Vineet-Menon/PDB_v1/Preview_files/PBD_3D.png

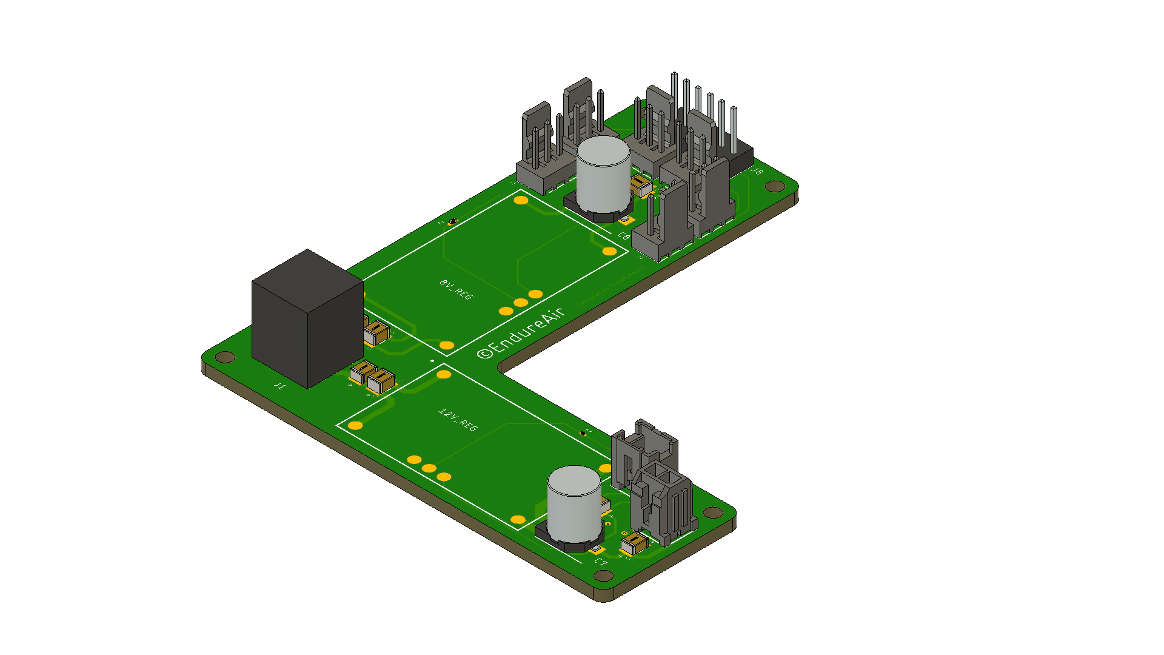
Preview_files/PBD_3D.png
