Vineet-Menon/PDB_v1/Design_files/PDB_final.step

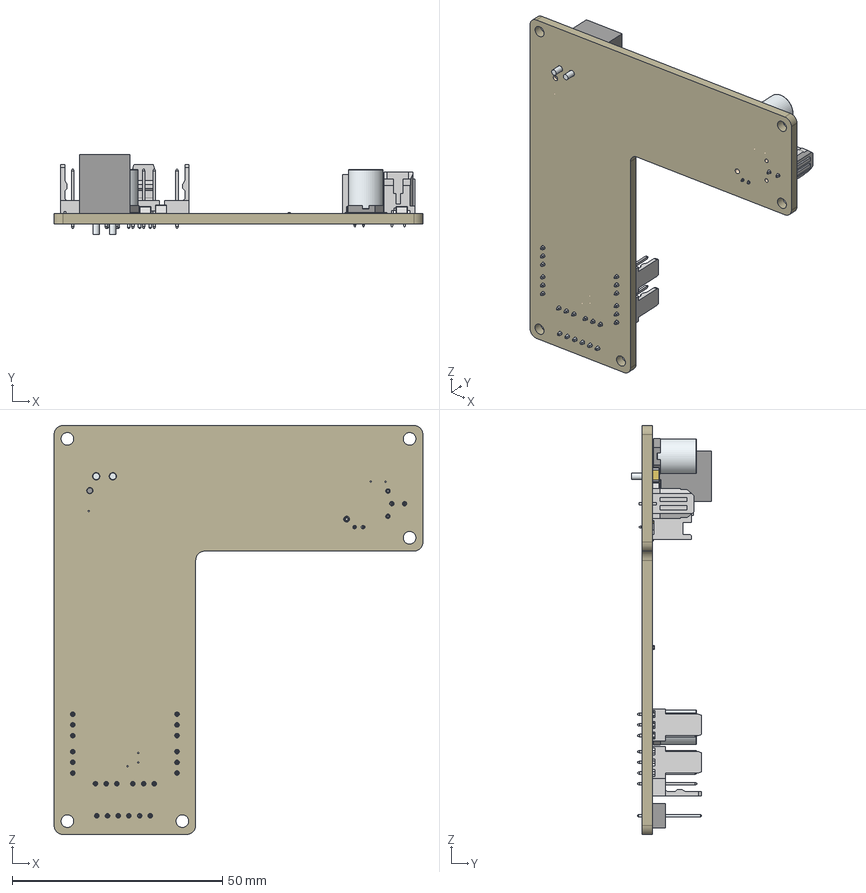
[picture p2: CAD file, 2020-01-20]
Design_files/PDB_final.step
87.6 x 19.1 x 97.2 mm
SimpleBody
LeadsArray
Leads x 3
lug3
Board
Base x 2
Pin1Fillet x 2
Pin2Fillet x 2
Base_75 x 5
Termination_75 x 10
Base_78 x 2
Termination_78 x 4
term1
term2
term1_1
term2_1
