Vineet-Menon/PDB_v1/Library_files/2.54mm_3pin_berg/22-27-2031.stp

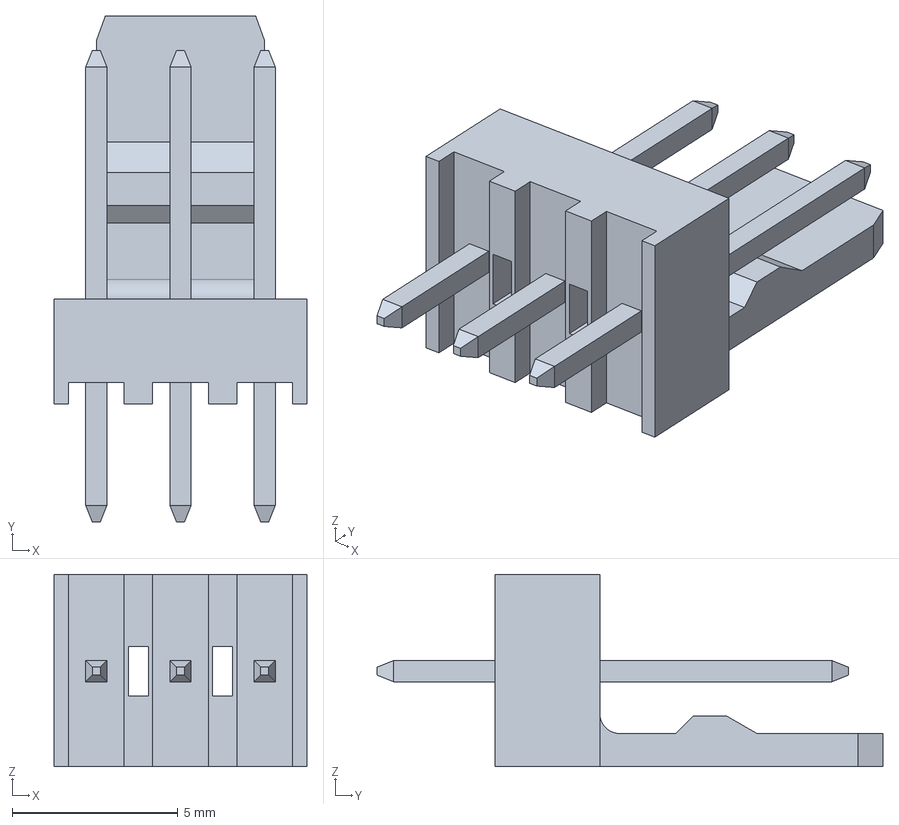
[picture p3: CAD file, 2020-01-20]
Library_files/2.54mm_3pin_berg/22-27-2031.stp
7.62 x 15.3 x 5.80 mm
