Vineet-Menon/PDB_v1/Library_files/2.54mm_6pin_berg/22-27-2061.stp

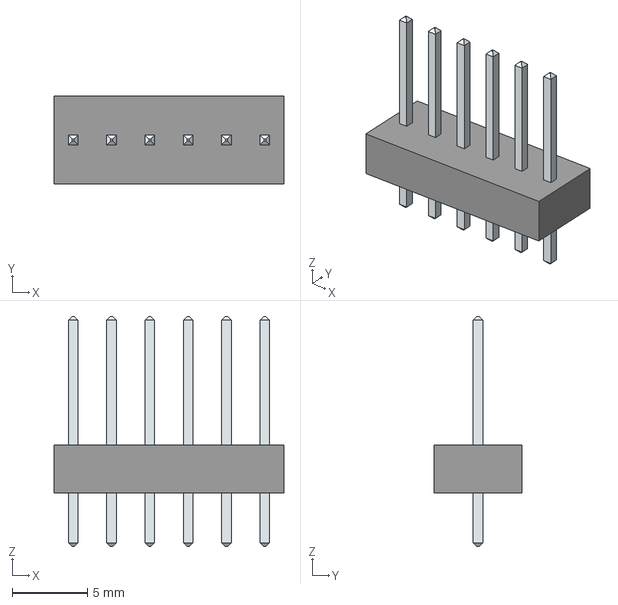
[picture p4: CAD file, 2020-01-20]
Library_files/2.54mm_6pin_berg/22-27-2061.stp
15.2 x 5.80 x 15.3 mm
SimpleBody
LeadsArray
