Vineet-Menon/PDB_v1/Library_files/6.04K_ohm_smd_resistor/ERJ-2RKF6041X.stp

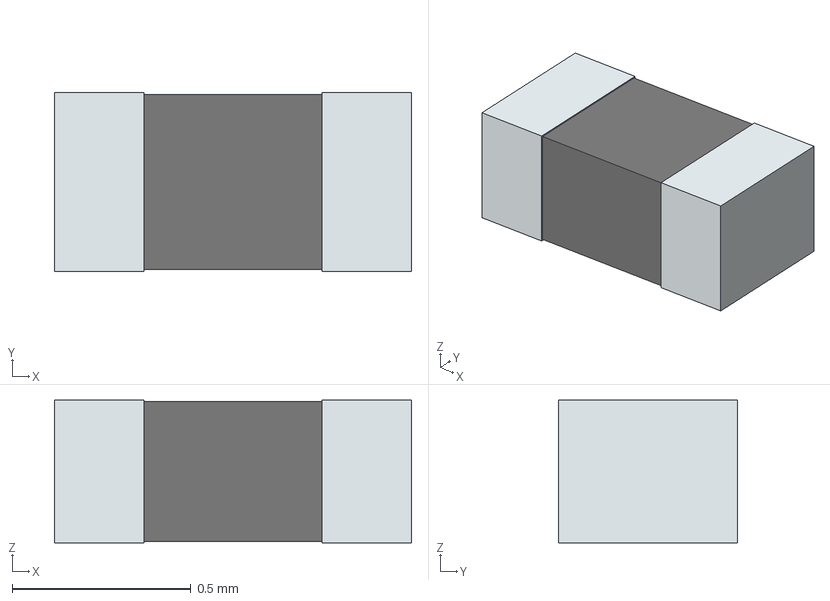
[picture p5: CAD file, 2020-01-20]
Library_files/6.04K_ohm_smd_resistor/ERJ-2RKF6041X.stp
1.00 x 0.5 x 0.4 mm
term1
term2
