Vineet-Menon/PDB_v1/Library_files/680_ohm_smd_resistor/RC0201FR-07680RL.stp

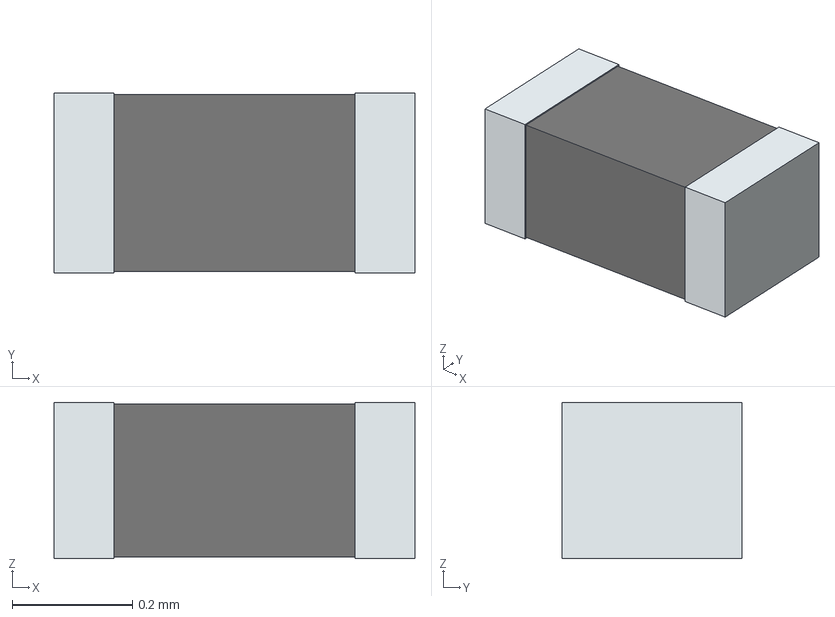
[picture p6: CAD file, 2020-01-20]
Library_files/680_ohm_smd_resistor/RC0201FR-07680RL.stp
0.6 x 0.3 x 0.26 mm
term1
term2
