Vineet-Menon/PDB_v1/Library_files/Kemet_1u_ceramic_capacitor/C1210C105K5RACTU.stp

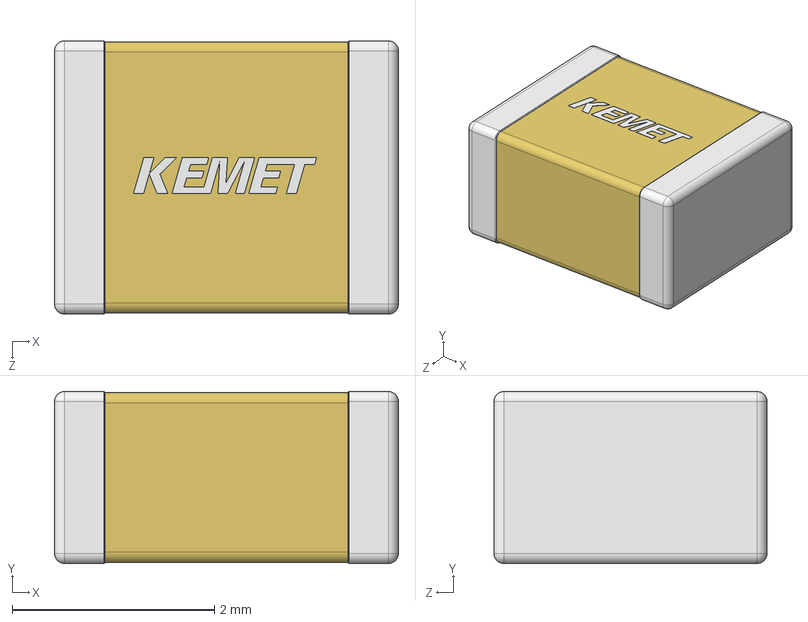
[picture p7: CAD file, 2020-01-20]
Library_files/Kemet_1u_ceramic_capacitor/C1210C105K5RACTU.stp
3.40 x 1.70 x 2.70 mm
Base_75
Termination_75 x 2
