Vineet-Menon/PDB_v1/Library_files/Kemet_2.2u_ceramic_capacitor/C1210C225K3RACTU.stp

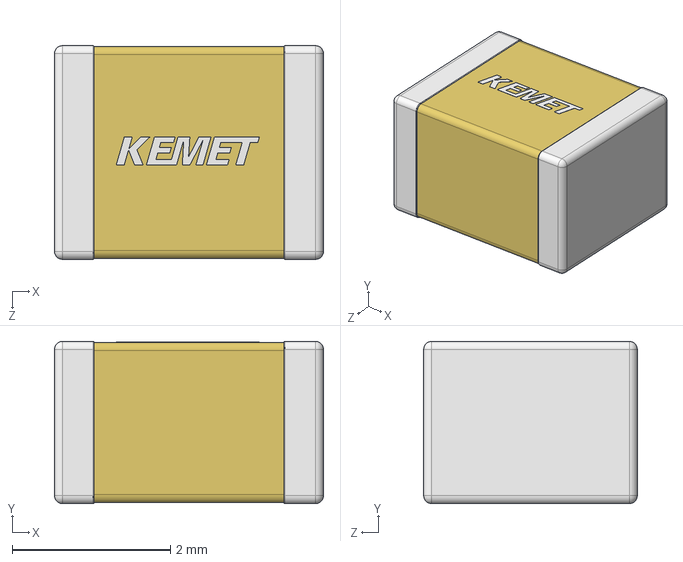
[picture p8: CAD file, 2020-01-20]
Library_files/Kemet_2.2u_ceramic_capacitor/C1210C225K3RACTU.stp
3.40 x 2.05 x 2.70 mm
Base_78
Termination_78 x 2
