Vineet-Menon/PDB_v1/Library_files/Panasonic_330uF_cap/EEE-FK1E331P.stp

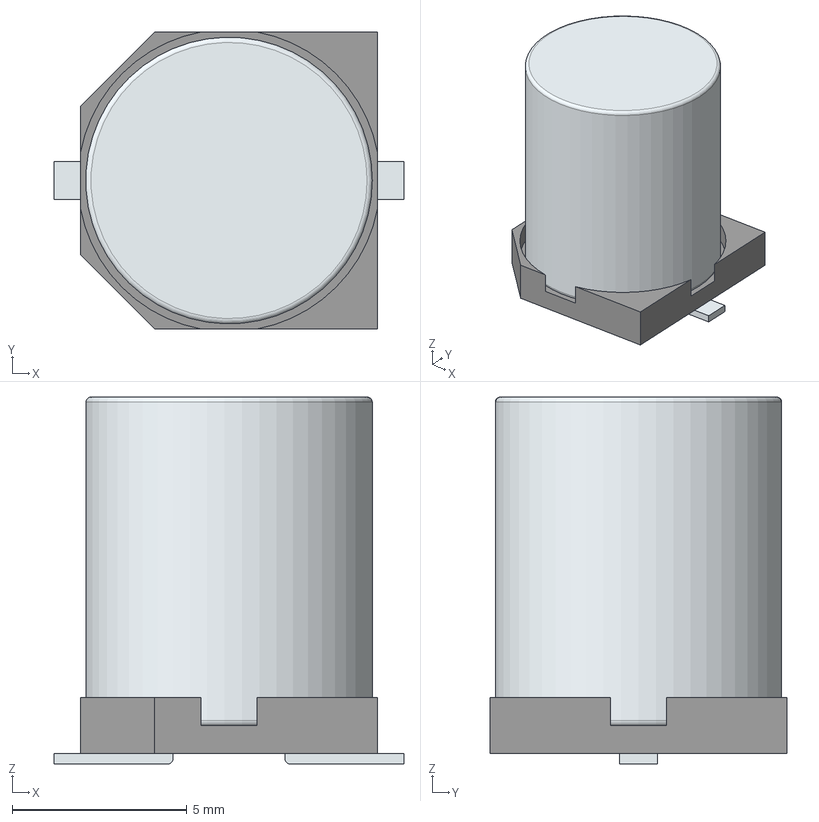
[picture p9: CAD file, 2020-01-20]
Library_files/Panasonic_330uF_cap/EEE-FK1E331P.stp
10.0 x 8.50 x 10.5 mm
Base
Pin1Fillet
Pin2Fillet
