Vineet-Menon/PDB_v1/Library_files/2-pin_11A_male-connector/207479-0002.stp

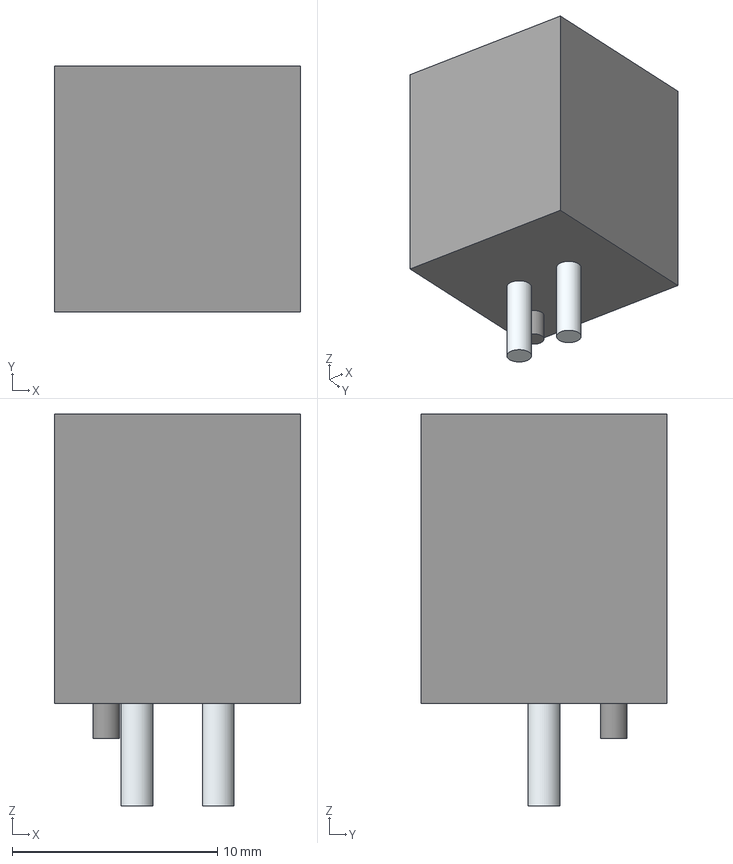
[picture p10: CAD file, 2020-01-20]
Library_files/2-pin_11A_male-connector/207479-0002.stp
12.0 x 12.0 x 19.1 mm
Leads x 3
lug3
