Vineet-Menon/PDB_v1/Library_files/2-pin_5.5A_male-connector/43045-0213.stp

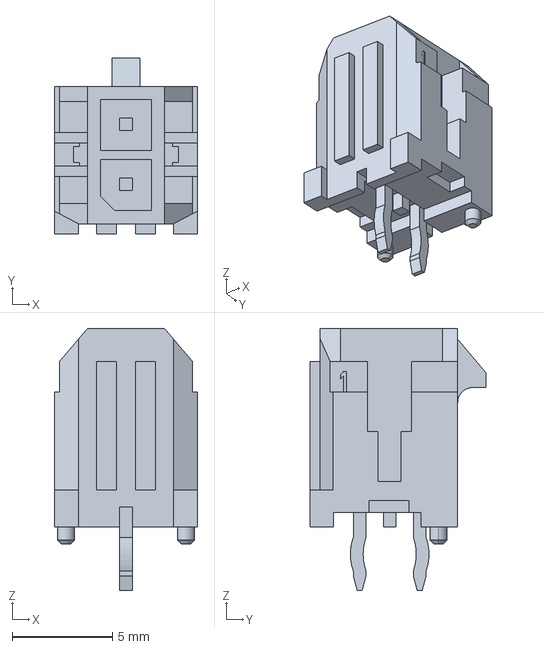
[picture p11: CAD file, 2020-01-20]
Library_files/2-pin_5.5A_male-connector/43045-0213.stp
7.15 x 8.77 x 13.1 mm
