Vineet-Menon/PDB_v1/Library_files/2pin_3A_male-connector/55932-0210.stp

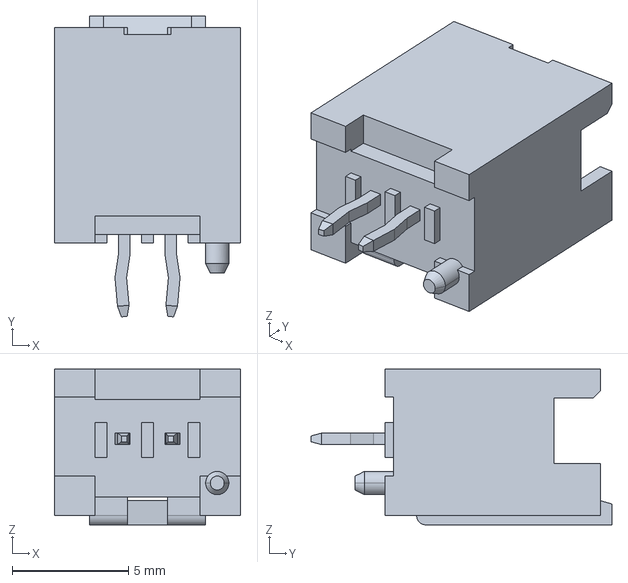
[picture p12: CAD file, 2020-01-20]
Library_files/2pin_3A_male-connector/55932-0210.stp
8.00 x 12.9 x 6.70 mm
