Vineet-Menon/PDB_v1/Preview_files/PDB_schematic.pdf

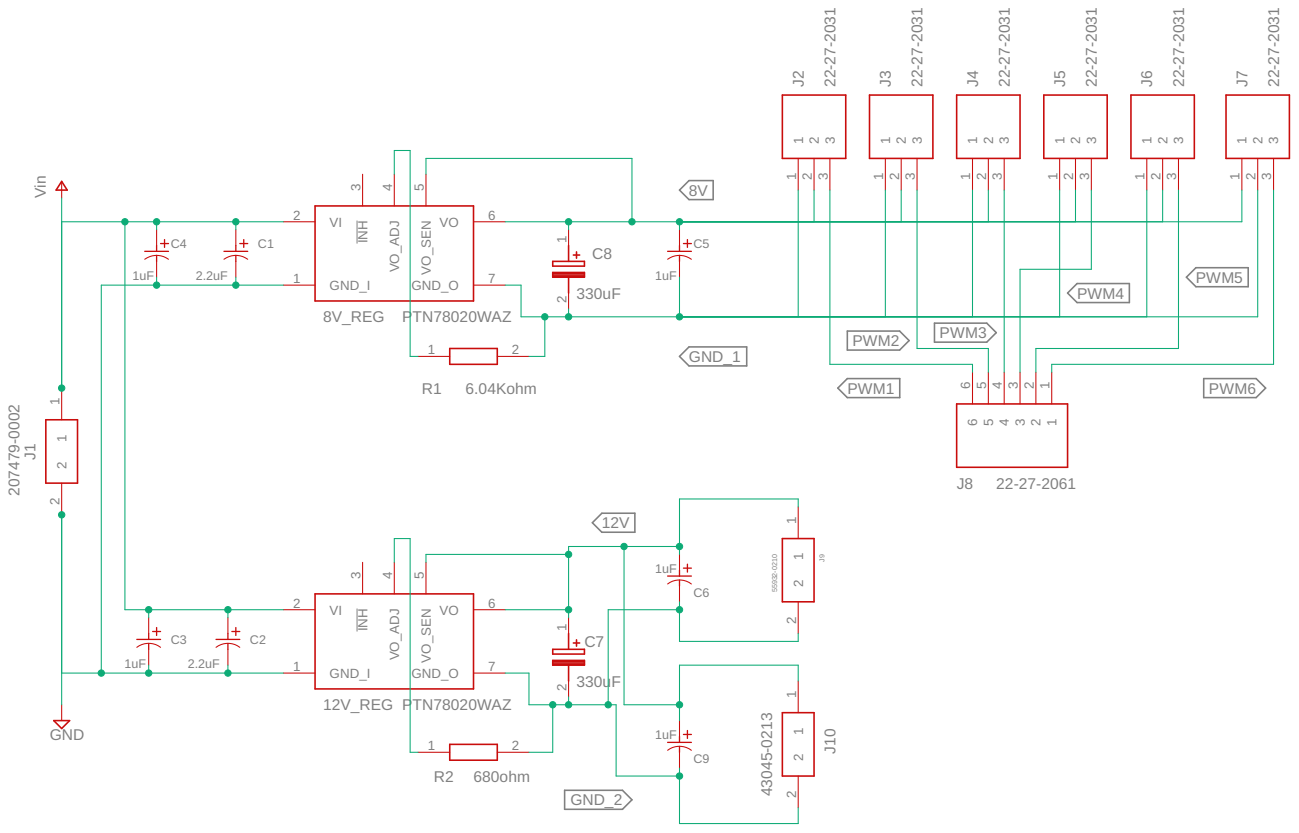
[picture p14: page 1]
