Vineet-Menon/PDB_v1/Preview_files/PDB_board.pdf

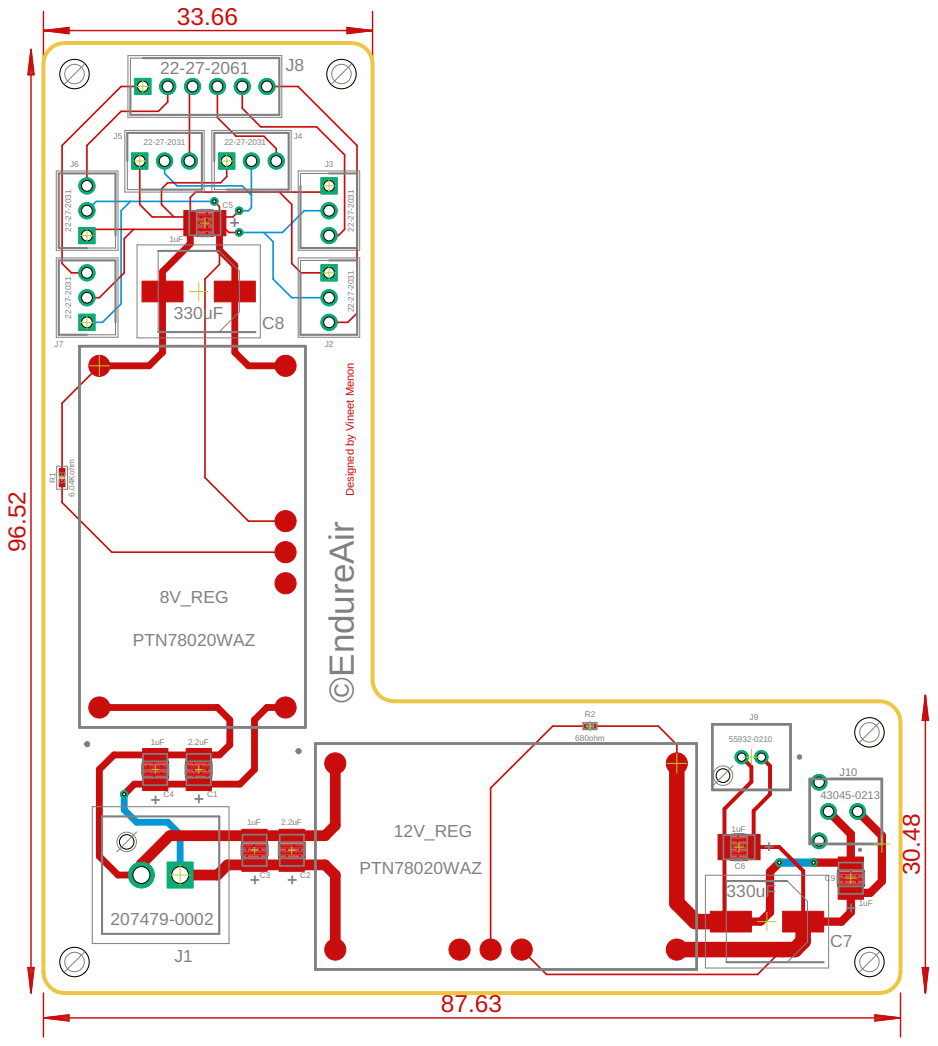
[picture p13: page 1]

Designed by Vineet Menon 33.66 96.52 87.63 30.48 ©EndureAir + 2.2uF + 2.2uF + 1uF + 1uF + 1uF + 1uF +1uF + ++ + + + + 12V_REG 8V_REGC1 C3 C2 C4 C5 C6 C7 C8 C9 J1 J2J3 J5 J4 J6 J7 J8 J9 R1 R2 J10 PTN78020WAZ PTN78020WAZ 330uF 330uF 207479-0002 22-27-2031 22-27-2031 22-27-2031 22-27-2031 22-27-2031 22-27-2031 22-27-2061 55932-0210 6.04Kohm 680ohm 43045-0213
